mcpherson/trig_laser_layout/resources/MIBSL.jpg

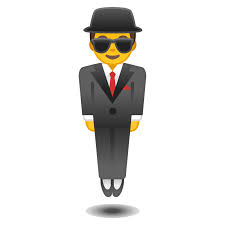
resources/MIBSL.jpg
