mcpherson/trig_laser_layout/(list of files, drawings)

Other design files:
resources/schematic.fzz
