mcpherson/trig_laser_layout/(commit log)

2025-04-11 manual drive mode now functions with one button and measures distance correctly
    [trig_laser_layout.cpp]
2025-04-13 fixed normalization and optimized code
    [trig_laser_layout.cpp]
2025-04-14 more normalization improvements to deal with backlash
    [trig_laser_layout.cpp]
2025-04-14 3 points are now logged. Improved instructions. Pushing before attempting to invert Y...
    [trig_laser_layout.cpp]
2025-04-14 Sensitivity now controls stepper speed
2025-04-17 added fritzing diagram
    [schematic.fzz]
